cody-kaminsky/drone_video_compression_v2/9-5.1.png

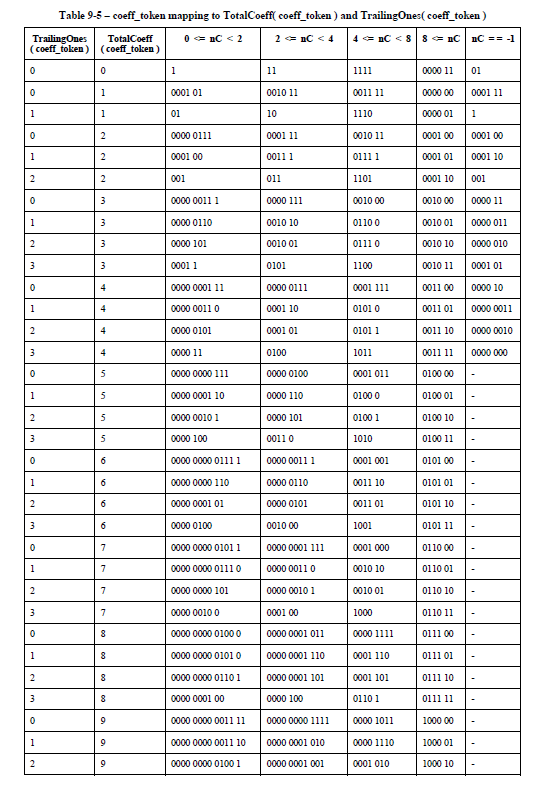
9-5.1.png
