cody-kaminsky/drone_video_compression_v2/9-7.png

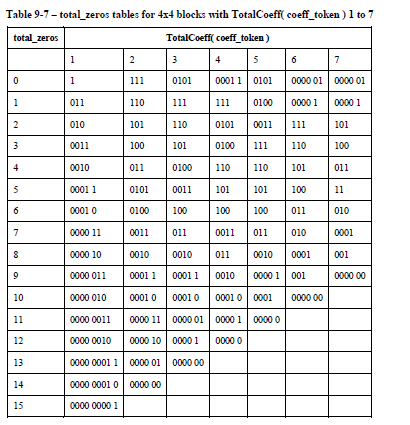
9-7.png
