cody-kaminsky/drone_video_compression_v2/9-8.png

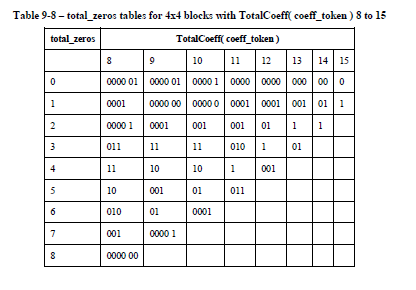
9-8.png
