cody-kaminsky/drone_video_compression_v2/9-9.png

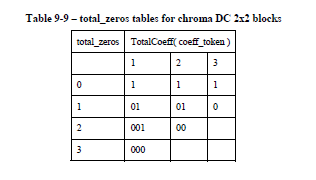
9-9.png
