cody-kaminsky/drone_video_compression_v2/9-10.png

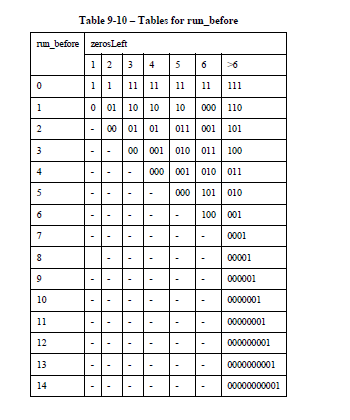
9-10.png
