cody-kaminsky/drone_video_compression_v2/src/vhdl/mb_header_engine.vhd

--------------------------------------------------------------------------------
-- mb_header_engine.vhd
--
-- Macroblock header for I slices: computes coded_block_pattern from the
-- per-block nonzero flags and emits the header syntax elements of spec
-- 7.3.5 as variable-length fields for a bit_packer, exactly as
-- mb_compute_cbp + mb_cavlc_emit in src/encoder.c do:
--
--   I_4x4   : mb_type ue(0); 16 x prev_intra4x4_pred_mode_flag [+ 3-bit
--             rem_intra4x4_pred_mode] in block scan order; intra_chroma_
--             pred_mode ue(v); coded_block_pattern me(v) (Table 9-4 intra
--             column); mb_qp_delta se(0) only if cbp != 0.
--   I_16x16 : mb_type ue(1 + mode + 4*cbp_chroma + 12*cbp_luma);
--             intra_chroma_pred_mode ue(v); mb_qp_delta se(0).
--
-- QP is fixed per frame, so mb_qp_delta is always 0 ('1'). Exp-Golomb
-- codes are emitted as one field: value v+1 with length 2*bits(v+1)-1;
-- the bit_packer treats the missing high bits as the leading zeros.
--
-- predIntra4x4PredMode (spec 8.3.1.1) uses the in-MB modes for inner
-- blocks and the line buffer's top/left modes at the MB edge; if either
-- neighbour is unavailable the prediction is DC.
--
-- luma_nz_i(k) (raster br*4+bc) must be "block k has a nonzero level"
-- over the 16 coefficients for I_4x4, or over the 15 AC coefficients for
-- I_16x16 -- the caller knows which levels it has.
--
-- One field per cycle while fready_i; a header takes at most 20 cycles.
--------------------------------------------------------------------------------

library ieee;
use ieee.std_logic_1164.all;
use ieee.numeric_std.all;

entity mb_header_engine is
    port (
        clk           : in  std_logic;
        rst_n         : in  std_logic;
        start_i       : in  std_logic;
        ready_o       : out std_logic;
        is_i4x4_i     : in  std_logic;
        mode16_i      : in  unsigned(1 downto 0);
        modes4_i      : in  std_logic_vector(63 downto 0);   -- 16 x 4 bits, raster
        mode_chroma_i : in  unsigned(1 downto 0);
        luma_nz_i     : in  std_logic_vector(15 downto 0);   -- raster
        chroma_dc_nz_i: in  std_logic;
        chroma_ac_nz_i: in  std_logic;
        mode4_top_i   : in  std_logic_vector(15 downto 0);   -- 4 x 4 bits (bc)
        mode4_left_i  : in  std_logic_vector(15 downto 0);   -- 4 x 4 bits (br)
        avail_top_i   : in  std_logic;
        avail_left_i  : in  std_logic;
        -- field stream
        fbits_o       : out unsigned(15 downto 0);
        flen_o        : out unsigned(5 downto 0);
        fvalid_o      : out std_logic;
        fready_i      : in  std_logic;
        -- results
        done_o        : out std_logic;
        hdr_bits_o    : out unsigned(7 downto 0);
        cbp_luma_o    : out unsigned(3 downto 0);
        cbp_chroma_o  : out unsigned(1 downto 0);
        has_residual_o: out std_logic
    );
end entity;

architecture rtl of mb_header_engine is

    type u8_tab is array (0 to 47) of integer range 0 to 47;
    constant CBP_CODENUM : u8_tab := (
         3, 29, 30, 17, 31, 18, 37,  8, 32, 38, 19,  9, 20, 10, 11,  2,
        16, 33, 34, 21, 35, 22, 39,  4, 36, 40, 23,  5, 24,  6,  7,  1,
        41, 42, 43, 25, 44, 26, 46, 12, 45, 47, 27, 13, 28, 14, 15,  0);

    type i16_tab is array (0 to 15) of integer range 0 to 3;
    constant SCAN_BR : i16_tab := (0,0,1,1, 0,0,1,1, 2,2,3,3, 2,2,3,3);
    constant SCAN_BC : i16_tab := (0,1,0,1, 2,3,2,3, 0,1,0,1, 2,3,2,3);

    -- Exp-Golomb ue(v) as (value, length): value = v+1, length = 2*bits-1
    procedure ue_field(v : in integer range 0 to 63;
                       bits : out unsigned(15 downto 0); len : out unsigned(5 downto 0)) is
        variable code : unsigned(6 downto 0);
        variable nb   : integer range 1 to 7;
    begin
        code := to_unsigned(v + 1, 7);
        if    code(6) = '1' then nb := 7;
        elsif code(5) = '1' then nb := 6;
        elsif code(4) = '1' then nb := 5;
        elsif code(3) = '1' then nb := 4;
        elsif code(2) = '1' then nb := 3;
        elsif code(1) = '1' then nb := 2;
        else                     nb := 1;
        end if;
        bits := resize(code, 16);
        len  := to_unsigned(2 * nb - 1, 6);
    end procedure;

    function mode_of(v : std_logic_vector; k : integer) return integer is
    begin
        return to_integer(unsigned(v(4*k+3 downto 4*k)));
    end function;

    -- Modes are held in block SCAN order and shifted out one per step; the
    -- neighbours a block needs are then fixed taps into a short history of
    -- the modes already emitted: top is 2 back (odd row of a quadrant) or
    -- 6 back (top row of quadrants 2/3), left is 1 back (odd column) or
    -- 3 back (blocks 4,6,12,14). No 16:1 muxes.
    type mode_arr is array (0 to 15) of unsigned(3 downto 0);
    type hist_arr is array (1 to 6) of unsigned(3 downto 0);

    signal busy      : std_logic := '0';
    signal step      : integer range 0 to 20 := 0;
    signal i4        : std_logic := '0';
    signal m16       : unsigned(1 downto 0) := (others => '0');
    signal sr        : mode_arr := (others => (others => '0'));
    signal hist      : hist_arr := (others => (others => '0'));
    signal mchroma   : unsigned(1 downto 0) := (others => '0');
    signal cbp_l     : unsigned(3 downto 0) := (others => '0');
    signal cbp_c     : unsigned(1 downto 0) := (others => '0');
    signal m4top, m4left : std_logic_vector(15 downto 0) := (others => '0');
    signal atop, aleft : std_logic := '0';
    signal fbits_q   : unsigned(15 downto 0) := (others => '0');
    signal flen_q    : unsigned(5 downto 0) := (others => '0');
    signal fvalid_q  : std_logic := '0';
    signal done_q    : std_logic := '0';
    signal nbits     : unsigned(7 downto 0) := (others => '0');
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
