cody-kaminsky/drone_video_compression_v2/(commit log)

2026-05-02 Initial commit: H.264 baseline-profile intra-only encoder
    A from-scratch C reference encoder for FPGA-targeted drone video
    compression. Validated byte-exact against ffmpeg across:
    - 5 4K drone images (3840x~2500): 25/25 pass at QPs 18,22,26,30,38
    - Kodak set (24 images, 768x512): 144/144 pass at QPs 18,22,26,30,38,46
    - Synthetic complex content: all sizes 16x16 to 768x128 at QPs 10-51
    Implements: NAL/RBSP framing, SPS/PPS, IDR slice header, I_16x16 + chroma
    8x8 prediction, 4x4 integer DCT + Hadamard for DC, full CAVLC entropy
    coding (coeff_token, levels, total_zeros, run_before).
    CAVLC tables verified against x264 reference (tools/diff_x264.py).
2026-05-02 Phase A: strip non-synthesizable scaffolding from encoder
    The C reference is the source of truth for the upcoming HLS port. Three
    classes of construct don't survive the trip and need to go before the
    structural refactor in Phase B:
    1. getenv / fprintf debug paths in hot loops (encoder.c, cavlc.c,
    bitstream.c) — neither synthesizes, and they obscure the dataflow that
    HLS needs to see.
    2. malloc / calloc / free for per-frame buffers (recon planes, nC arrays,
    RBSP slice payload). Replaced by a static arena sized for the
    architecture max (MAX_W x MAX_H = 4K). Total ~24 MB of .bss, of which
    the active sub-region is memset on each call.
    3. Self-recursion in predict_chroma_8x8 (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
    [bitstream.c, cavlc.c, encoder.c, intra.c]
2026-05-02 Phase B: split encode_mb_emit into typed pipeline stages
    The old encode_mb_emit was a 275-line monolith that interleaved mode
    decision, forward+inverse transforms, CBP derivation, and CAVLC emission.
    That structure doesn't map onto the architecture diagram in §8 of
    architecture.txt, and it's the wrong shape for the HLS port: HLS needs
    each pipeline stage as its own pure function with a typed payload between
    stages so it can pragma-pipeline across stage FIFOs.
    This commit factors the per-MB encode into 8 stage functions matching
    architecture.txt §9 one-for-one:
    stage 0 mb_fetch gather src + neighbor samples
    stage 1 mb_mode_decide I_16x16 SATD + chroma SAD picks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
    [encoder.c, mb_state.h]
2026-05-02 Phase C: separate PSNR / bpp from the encoder kernel
    The FPGA encoder IP, per architecture.txt §10, returns BS_BYTES_OUT and
    perf counters — it does not compute PSNR. PSNR is a host-side measurement
    function, and putting it inside the kernel ties the C reference to a
    shape the hardware will not have.
    Moved psnr_plane and psnr_chroma_component into a new psnr.h/psnr.c
    module. encode_frame_h264 (the bitstream-emitting kernel that maps to the
    FPGA IP) is now integer-only — no doubles, no math.h, no log10. It fills
    total_bits, bytes_out, mb_count and leaves the PSNR / bpp slots in
    encode_stats_t at zero.
    main.c is the test bench: after the kernel returns it computes PSNR from
    src vs the r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
2026-05-02 Graft I_4x4 onto the staged emit path; drop the bit-estimate prototype
    The architecture (architecture.txt §2) keeps both I_16x16 and I_4x4 luma
    intra prediction in scope, and §9 budgets the mode-decision SATD engines
    to evaluate all 9 I_4x4 modes alongside the 4 I_16x16 modes. Until now
    I_4x4 only existed in encode_mb's bit-estimation prototype; the bitstream
    emitter (encode_frame_h264 + encode_mb_emit) was I_16x16-only. This commit
    folds I_4x4 into the staged pipeline and removes the prototype.
    Approach
    --------
    mb_mode_decide now runs both candidate paths in full (forward + inverse
    + recon for each) and picks the winner by estimated CAVLC bits. I_4x4's
    per-block dependency chain forces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
2026-05-02 Disable I_4x4 path selection until cross-MB-boundary bug is found
    Running tools/validate_byteexact.sh against the Kodak (24 imgs) and drone
    aerial (5 imgs) datasets revealed that the I_4x4 graft has a real bug:
    all 120 Kodak tests fail when the path selector is active, with no ffmpeg
    parser errors but with consistent recon divergence at the first I_4x4 ↔
    I_16x16 macroblock boundary in raster order.
    Diagnostic data:
    - I_16x16-only (forced bits_b = MAX): 145/145 byte-exact across both
    datasets and QPs 18/22/26/30/38.
    - I_4x4-only (forced bits_a = MAX): byte-exact on every individual test
    case I tried (kodim01 at QP 18/26/38 confirmed).
    - Mixed (selector active): 120/120 Kodak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
    [encoder.c, types.h]
2026-05-03 Add CAVLC self-check + I_4x4 bug debug session findings
    Two changes:
    1. CAVLC self-check (cavlc.c). Guarded by `#ifdef CAVLC_SELFCHECK`,
    wraps cavlc_encode_block to encode-then-decode each block to a
    scratch buffer and compare. Built with -DCAVLC_SELFCHECK and ran
    against the failing case (kodim01 QP30 with I_4x4 selector active):
    zero mismatches reported. The CAVLC layer is consistent given the
    encoder's nC.
    2. Updated docs/i4x4-boundary-bug.md with this session's findings:
    - Per-MB forcing bisect localized the bug as content/mode-specific,
    NOT just any I_4x4-with-I_16x16-neighbor case. Forcing only
    MB (0, 2) to I_4x4 triggers the bug; forcing only MB (0, 1) or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
    [cavlc.c, encoder.c]
2026-05-05 Add per-MB self-decoder; rules out broad classes of bugs
    Built a full per-MB CAVLC self-decoder in encoder.c (under
    #ifdef MB_SELFDECODE). After each mb_cavlc_emit call, it:
    1. Re-parses the MB's emitted bits using our cavlc_decode_block.
    2. Walks every syntax element: mb_type, 16 prev/rem mode flags
    (with full predIntra4x4PredMode lookup), intra_chroma_pred_mode,
    me(CBP), mb_qp_delta, residual blocks (luma DC for I_16x16,
    full luma for I_4x4, chroma DC, chroma AC).
    3. Compares every parsed value to encoder intent (mb_state_t).
    4. Maintains parallel dec_state that mirrors a spec decoder's
    tracked neighbor counts; compares to encoder's ncs after each MB.
    Result on kodim01 QP30 w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
    [encoder.c]
2026-05-05 Fix I_4x4 boundary bug; M2 cleanups for HLS port
    The I_4x4 ↔ I_16x16 boundary bug was a spec misinterpretation in
    emit_intra4x4_mode (and the mirrored copy in verify_mb_at): when either
    4x4 neighbor was inside an I_16x16 macroblock, the code forced
    predIntra4x4PredMode = DC instead of substituting effective mode 2 (DC)
    for that neighbor and then taking Min(top, left). The distinction
    matters whenever the OTHER neighbor's mode is < 2 (V or H): spec wants
    Min(mode, 2) = mode, but the buggy code wrote 2. Encoder and self-
    decoder shared the wrong rule, so MB_SELFDECODE never caught it; pure-
    I_4x4 and pure-I_16x16 runs hit the wrong branch zero times, so they
    were byte-exact. Mixed-mode was t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
    [encoder.c]
2026-05-05 M3 phase 1: HLS port with line-buffered recon (src/hls/)
    The C reference in src/ is untouched; the HLS-targeted port lives in
    src/hls/ as a separate set of source files that share the transform /
    quant / intra / cavlc / bitstream / nal / psnr modules with the C
    reference. Both binaries (build/dcc_encoder and build/dcc_hls) are
    built from the same Makefile.
    Key change vs C reference: the W*H static recon plane (3.1 MB at 1080p,
    15 MB at MAX_W*MAX_H) is replaced by a line buffer holding only the
    edges intra prediction actually reads — bottom row of the MB row above
    plus the right column of the MB just to the left. Footprint at 1080p
    drops to ~15 KB, well within Zynq-7030 BRAM.
    src/hls/li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
    [encoder.c, encoder_hls.h, hls_pragmas.h, hls_top.c, line_buffer.c, line_buffer.h, main.c]
2026-05-05 M3.2: HLS pragmas + Vitis HLS driver scripts
    Annotates the HLS port for synthesis, ready to run vitis_hls -p
    src/hls/csynth.tcl. Pragmas are gated by HLS_PRAGMA() (defined in
    hls_pragmas.h) — inert under gcc, so the dcc_encoder and dcc_hls
    binaries continue to build byte-exact against ffmpeg / each other.
    src/hls/encoder.c
    - ARRAY_PARTITION on mb_state_t large fields inside encode_mb_emit
    (ac_levels_y_full, ac_levels_*, dc_levels_*, neighbor edges,
    modes4) so inner loops can reach II=1.
    - PIPELINE pragmas on the chroma forward / inverse / quant / recon
    4-block loops in mb_residual / mb_transform / mb_quantize /
    mb_reconstruct.
    - LOOP_TRIPCOUNT hints o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
2026-05-05 HLS: replace line-buffer pointer-swap with index flip
    Vitis HLS rejects pointer phi nodes — pointers whose underlying object
    depends on a runtime-decided control path are not synthesizable
    ("Pointer (phi) points to an unknown underlying object", HLS 214-390).
    The line_buffer ping-pong used pointer swaps in lb_begin_mb_row to
    promote the just-filled bank into the read position. After the swap,
    every gather_* call's read of lb->top_y was a phi between two
    underlying static arenas — exactly the pattern HLS can't bind.
    Fix: store both banks inside line_buffer_t as a [2][MAX_W] array and
    keep an integer top_idx selecting which bank is the read side. Reads
    become buf_y[lb->top_idx][...]; wri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
    [encoder.c, line_buffer.c, line_buffer.h]
2026-05-05 HLS iteration 2: line-buffer all the cross-MB state, relax pragmas
    Closes the BRAM blowout (1018% utilization in iteration 1) by extending
    the line-buffer pattern beyond the recon plane to ALL frame-scale
    arenas. Same access pattern, same fix.
    Structural change — nC and mode4 join recon in line_buffer_t:
    Before: arena_luma_nc / arena_chroma_u_nc / arena_chroma_v_nc /
    arena_luma_mode4 — frame-scale grids of 4x4-block context.
    Sized W/4 * H/4 (luma) and W/8 * H/8 (chroma). At MAX_W=3840
    that's ~720 KB total.
    After: All four collapsed into line_buffer_t — top row + left col
    per channel. ~5 KB total. Same ping-pong + index-flip shape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
    [encoder.c, line_buffer.c, line_buffer.h]
2026-05-06 HLS iteration 3: skip per-frame NAL writes + CAVLC heuristic for synth
    Two surgical __SYNTHESIS__-only changes targeting the LUT explosion that
    iteration 2 didn't touch. Both keep the gcc-built dcc_hls.exe byte-
    identical to the C reference.
    (1) Skip nal_write_sps / nal_write_pps / nal_emit_idr under __SYNTHESIS__.
    These run ONCE per frame, write ~30 bytes total, but synthesize to
    ~40k LUT (50% of the xc7z030 budget) because their bs_put_ue /
    bs_put_se / RBSP-escape inner loops are variable-length-output
    machinery that HLS expands fully. For a fixed (W, H, qp) target the
    SPS+PPS bytes are CONSTANT — the right place to compute them is once
    on the host (PS) at boot,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
    [encoder.c]
2026-05-06 HLS iteration 4: drop I_4x4 candidate + force kernel sharing
    User-flagged the obvious: comparable H.264 baseline encoders are in the
    20-30k LUT range. Iteration 3 still landed at 177k (225%), 6-9x off.
    Two attacks:
    (1) Drop try_path_i4x4 from synthesis.
    The C reference evaluates BOTH I_16x16 and I_4x4 candidates and
    picks the cheaper. try_path_i4x4 alone consumed ~22% of the LUT
    budget — it runs a full per-block forward+inverse loop, evaluates
    9 prediction modes per block, and computes a CAVLC bit estimate,
    even when I_16x16 wins (which is the common case).
    Under __SYNTHESIS__, force bits_b = INT32_MAX so the selector
    always picks I_16x16. Per architecture.txt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
2026-05-06 M4 phase 1.5: stub cavlc_encode_block under __SYNTHESIS__ (preview only)
    Replaces all 9 cavlc_encode_block call sites in src/hls/encoder.c with
    a CAVLC_ENCODE_BLOCK macro. Under __SYNTHESIS__ the macro expands to a
    no-op (just (void) casts to silence unused-variable warnings); under
    gcc it expands to the real cavlc_encode_block call.
    This is a SYNTHESIS-REPORT PREVIEW only. The synthesized hardware does
    not emit residual data, so cosim and ffmpeg-decode parity will fail.
    The point is to see the LUT count Vitis HLS produces with CAVLC's 12k
    LUT block factored out — i.e., what M4 phase 2 step 6 (HLS refactor to
    hls::stream<level_packet_t>) will eventually deliver, before doing the
    full VHDL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
    [encoder.c]
2026-05-06 docs: M4 architecture-pivot plan (no code change)
    Captures the decision to move from "HLS does everything" to "HLS as
    director + hand-VHDL for dataflow blocks". Self-contained handoff
    document for resuming M4 work in a new session.
    Contents:
    1. Current state — commit history, build status, last synthesis
    numbers (LUT 153% with CAVLC stubbed; 201% with CAVLC inline;
    projected ~80% with full M4 + dropping functionality).
    2. Pivot rationale — comparable hand-VHDL designs ship at 20-30k
    LUT WITH all functionality; HLS keeps generating 6-9× the
    hardware. The fix isn't more pragmas, it's switching paradigms.
    3. New architecture — top-level diagram, per-block estim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
2026-05-15 fix bit_packer: out_last race on flush + TEXTIO integer overflow
    The out_last signal was never asserted when flush_i arrived in the same
    cycle as the final full-byte emission (state still S_NORMAL). Also, the
    testbench used integer READ for 32-bit unsigned values, overflowing on
    values > 2^31-1. Switch vector format to hex and use hread.
    [bit_packer.vhd, bit_packer_tb.vhd]
2026-05-15 fix cavlc_engine: run_before loop exiting one iteration early
    The loop condition idx <= 1 skipped the final run_before between
    nz_pos[1] and nz_pos[0]. Changed to idx < 1 to match the C reference
    loop (idx >= 1 && zeros_left > 0).
    [cavlc_engine.vhd]
2026-05-15 tcl: switch sim scripts to explicit xvhdl/xelab/xsim flow
    Replace create_project/launch_simulation with direct xvhdl, xelab, xsim
    calls so the scripts work in a plain Vivado Tcl console without needing
    project infrastructure.
2026-05-15 fix transform_engine: truncate i16 outputs + exec xsim in tcl scripts
    dct4x4 and hadamard2x2 output i16 in C; the VHDL was returning full
    32-bit results, causing mismatches on overflow inputs. Add trunc16 to
    match the C (i16) cast. Also fix xsim calls to use exec prefix.
    [transform_engine.vhd]
2026-05-15 transform_engine: shared butterfly, single-cycle, area-optimized
    Replace 8×3 duplicated butterfly instances with 8 instances of one
    shared mode-muxed butterfly. Same 1-cycle latency and throughput.
    Synthesizer can now share pre-add logic across DCT/IDCT/Hadamard modes.
    [transform_engine.vhd]
2026-05-15 fix cavlc_engine_tb: collect bytes by count, not out_last
    When bit_count is an exact multiple of 8, all full bytes are emitted
    during encoding before the flush. The bit_packer's flush finds an
    empty accumulator and never asserts out_last, causing the testbench
    to hang. Fix by collecting exactly exp_count bytes, then waiting for
    the engine to return to idle (in_ready).
    [bit_packer.vhd]
2026-09-09 cavlc_engine: fix dropped pushes, pipeline count, cut area 2919 -> 774 LUTs
    Functional fixes:
    - bit_packer: remove stray `end if;` that broke compilation (sims were
    silently using a stale library copy).
    - cavlc_engine: hold bp_valid until the packer accepts. Ready was sampled
    a cycle early and not held, so a 28-bit escape level pushing the
    accumulator past 32 bits dropped the following field (first seen at
    vector 21). Latch the coeff_token pulse; flush only with nothing pending.
    Timing / area:
    - Split the S_COUNT scan into mask + count stages (was a 16-deep chain
    of 16-bit compares into trailing_ones; WNS -2.18 ns -> +0.38 ns at
    200 MHz on xc7z030-3).
    - Walk the nonzero mask wit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
    [bit_packer.vhd, cavlc_engine.vhd, cavlc_vlc_rom.vhd, coeff_token_encoder.vhd]
2026-09-10 vhdl: dataflow blocks (transform, quant, predict, cost, recon, line buffer, MB header, CAVLC dispatch)
    Area-optimized transform_engine (shared butterfly, W=20, DIR generic).
    New engines with C-golden testbenches and xsim drivers:
    quant_engine, predict_4x4/16x16/chroma_engine, cavlc_cost_engine
    (systolic, lat 19) and cavlc_cost_engine_ll (position-parallel, lat 5),
    recon_engine (optional SSD), line_buffer (HLS line_buffer_t in HW),
    mb_header_engine (CBP + Exp-Golomb header fields), cavlc_dispatch
    (per-engine packet FIFOs, order FIFO, in-order byte merger).
    bit_packer: per-flush-group bit count. cavlc_engine: block_bits_o and
    flushed_o ports, single-shot drain flush, registered level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
2026-09-10 encoder kernel: N=3 mode decider, MB pipeline controller, frame I/O, top
    C reference: I_4x4 decision is now SATD screen + mode-bit penalty,
    3-candidate shortlist scored by J = 16*SSD + lambda*bits (integer
    tables in src/rd_tables.h); HLS copy updated; per-MB and per-frame
    vector dumps (DCC_DUMP_MB / DCC_DUMP_SRC / DCC_DUMP_SLICE / DCC_DUMP_ITEMS).
    VHDL: mode_decide_engine (shared datapath, tagged free-running
    pipelines, wavefront pairs, chroma screen in idle windows),
    mb_pipeline_controller (line buffer + decider + header + CAVLC dispatch,
    nC/zigzag/packets, double-buffered source), frame_io (MB-row buffer
    re-tiled to 4x4 words, 32-bit AXI-Stream in/out), encoder_top.
    predict_16x16_engine: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
    [encoder.c, encoder_top.vhd, encoder_top_tb.vhd, frame_io.vhd, frame_io_tb.vhd, mb_pipeline_controller.vhd, mb_pipeline_controller_tb.vhd]
2026-09-10 mode decider: register stages for timing (recon input, rank insert, rate term, 4x4 predictor inputs); frame_io lane RAMs + registered write address; hex pixel stream
2026-09-10 mode decider: open-loop screen hybrid, fused dequant, J fold; controller overlap; 3-frame 1080p test
    Decision policy (C reference, HLS copy, rd_tables.h): the I_4x4 screen ranks
    every mode against open-loop neighbours (reconstructed where the neighbour is
    another MB, source where it is in-MB); the top-3 shortlist is still evaluated
    closed-loop. C sweep: -3.45% BD-rate vs the SATD-only reference, 0.6% behind
    the closed-loop screen. Reference == HLS byte-exact, ffmpeg decode exact.
    mode_decide_engine: screen sequencer (16 blocks in wavefront order, 4-cycle
    source-RAM prep, dedicated 14-bit Hadamard lane + abs tree, per-block top-4
    lists + raw SATD RAM), chain sequencer (prep, 2-cycle rank wit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
    [cavlc_engine.vhd, encoder.c, encoder_top_mf_tb.vhd, mb_pipeline_controller.vhd, mode_decide_engine.vhd, quant_engine.vhd, rd_tables.h, transform_engine.vhd]
2026-09-11 AXI wrapper, OOC implementation flow, post-route timing fixes
    encoder_axi_top: AXI4-Lite registers (CTRL START/SOFT_RESET/IRQ_EN, CONFIG,
    STATUS, DONE_CLR, FRAMES, CYCLES, BYTES, ID, VERSION), AXI4-Stream pixels in
    and slice payload out (tkeep/tlast), level interrupt, synchronised reset.
    s_axis_tready is held low until START (frame_io accepts and then discards
    words that arrive before frame_start, which corrupted MB 0 when the DMA was
    started early). encoder_axi_top_tb: two frames through AXI, bit-exact,
    register readback checked.
    Timing (from the first post-route report): the transform's DC vector is
    registered when the background issues the HAD beat (W_FWDC 9 -> 10); the
    controller builds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
    [encoder_axi_top.vhd, encoder_axi_top_tb.vhd, mb_pipeline_controller.vhd, mode_decide_engine.vhd]
2026-09-13 M5: package the kernel as IP and build the hardware validation framework
    Target for bring-up is a Zybo Z7-20 (xc7z020clg400-1) at 110 MHz,
    bare-metal. Everything here is verified except the two files that need the
    Vitis BSP.
    Measured on the real part, full out-of-context place and route at 9.091 ns:
    WNS +0.048 ns, WHS +0.028 ns, 23304 LUT (44%), 14651 FF (14%), 29.5 BRAM
    (21%), 49 DSP (22%). An older characterisation had the -1 part at about
    105 MHz with 9.0 ns failing by 0.168 ns; the register-stage work since then
    moved it. The margin is thin, so 110 MHz is a measured ceiling, not a
    comfortable operating point.
    At 337 cycles per macroblock, 1080p is 25.0 ms a frame, so 40 fps. Dropping
    f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
    [board_main.c, codec_kernel.c, codec_kernel.h, h264_host.c, h264_host.h, platform_standalone.c, test_assemble.c]
2026-09-13 M5: Zybo block design, Vitis setup, and a bring-up runbook
    The block design now builds for real. Digilent's board files are installed
    (github.com/Digilent/vivado-boards), and build_zybo_bd.tcl validates end to
    end: PS7 + AXI DMA + the packaged encoder IP, with the encoder at 0x43C00000
    and the DMA at 0x40400000.
    Three things the first run of the script got wrong, all of the kind that
    fails late rather than loudly:
    - The board part was pinned at version 1.0 and the installed one is 1.2.
    A pinned version fails with "not found", which reads like a missing
    install rather than a version bump, so it is resolved by glob now.
    - IPs were named by bare VLNV with no version, which does n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
    [board_main.c]
2026-09-13 M5: Zybo bitstream built at 100 MHz, WNS +0.094 ns
    build/zybo/dcc_enc.xsa and the bitstream exist. 25945 LUT (49%), 18183 FF
    (17%), 34.5 BRAM (25%), 49 DSP (22%), WHS +0.024 ns, no failing endpoints.
    The plumbing costs only about 1900 LUTs and 5 BRAM tiles over the kernel.
    The slack is the interesting part, because it says my earlier estimate was
    wrong in a way worth writing down. Out-of-context slack does not extrapolate
    to in-system slack. The worst path is the same one the OOC run found, the
    mode decider's transform input select into the transform row register, but it
    went from about 9.04 ns standalone to 9.767 ns in the system, and 66% of that
    is routing rather than logic. The encoder p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
2026-09-13 M5: the bare-metal application builds
    The Vitis workspace, platform and application are created and dcc_l4.elf
    links: 281 kB text, 1.27 MB bss, 554 kB on disk. board_main.c and
    platform_standalone.c were the two files that had never seen a compiler, and
    both needed a fix, each Cortex-A9 specific:
    - xtime_l.h does not exist in a Cortex-A9 system-device-tree BSP. It is an
    UltraScale+ (A53/R5) header. The same XTime_GetTime and COUNTS_PER_SECOND
    come from xiltimer.h, which includes xtimer_config.h. Also parenthesise
    COUNTS_PER_SECOND before dividing again: it expands to a bare
    XPAR_CPU_CORE_CLOCK_FREQ_HZ/2 and reassociates otherwise.
    - XAxiDma_Busy returns u32, so %d is a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
    [board_main.c, platform_standalone.c]
2026-09-13 M5: L4 passes on hardware
    A Zybo Z7-20 at 100 MHz encoded the 480x272 test frame and produced a payload
    byte-exact with the C reference: 18717 bytes, matching the simulation and the
    reference, and an 18744-byte Annex B access unit. The chain from the spec
    through the C encoder, the RTL, the packaged IP, the block design and the DMA
    is intact end to end on real silicon.
    174350 cycles, 342 cycles/MB, 1.74 ms. That is 563 cycles (0.32%) faster than
    simulation's 174913, which is worth understanding rather than shrugging at.
    Two effects cancel: board_main.c pulses START before programming the MM2S
    transfer, so the kernel idles while the CPU writes DMA registers, but the real
    DMA streams from DDR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
2026-09-13 M5: manifest-driven sequence run, no staging copy
    Replaces the single linked-in frame with a sequence loaded into DDR over
    JTAG and described by a manifest, so the board application is
    resolution-independent and changing the test sequence never needs a
    recompile.
    The frames are written to DDR already in the kernel's stream order, shuffled
    once on the workstation by tools/gen_stream_frame.c, which calls the same
    h264_nv12_to_stream() that make host_test covers. So the board does no
    staging copy at all: MM2S reads each frame where it lies. At 1080p that
    removes about 3 MB of memcpy per frame, which was the main thing eating the
    33 ms budget at 30 fps and the main argument for reaching for
    sca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
    [board_main.c, dcc_memmap.h]
2026-09-13 M5: the board waits for the manifest instead of needing a breakpoint
    The application read the manifest once at startup, so launching it from Vitis
    meant it ran straight past and reported a missing manifest before the data
    could be pushed in. Avoiding that needed a breakpoint at main, which is fiddly
    and easy to get wrong.
    It now polls for the manifest and prints what to run. The order becomes:
    launch from Vitis, let it run, then run the generated load.tcl, which halts the
    core, writes the data and resumes into the poll.
    The poll invalidates the cache on every pass. JTAG writes DDR behind the data
    cache, so once the loop has read that address the CPU would hold the stale line
    forever and ne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
    [board_main.c]
2026-09-13 M5: bound every wait, dump state on a stall, consume the manifest
    The 1080p run passed frame 0 (256713 bytes byte-exact, 338 cycles/MB against
    simulation's 337) and then stopped dead on frame 1 with no message. That is
    this file's fault, not the kernel's: the wait for S2MM to go idle had no
    timeout at all, and every other bound went through dcc_time_us(), which
    silently becomes infinite if the A9 global timer is not running. An infinite
    wait is indistinguishable from a hardware hang.
    Every wait is now bounded by an iteration count that does not trust the
    timer, and a stall prints what it was waiting for plus the kernel STATUS
    decoded bit by bit, FRAMES/CYCLES/BYTES, and both DMA channels' c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
    [board_main.c]
2026-09-13 M5: add scripts/clear_manifest.tcl
    DDR does not reliably clear on a power cycle, so a manifest can outlive the
    frames it describes. The application now clears its own magic after latching
    one, but an interrupted load or a crashed run can still leave a plausible
    manifest behind. This zeroes the header and reads it back to confirm.
    Wiping DDR wholesale is not the answer: the frame region alone is 448 MB, and
    filling it over JTAG would take hours. The magic is the only word that gates
    anything.
2026-09-13 M5: find the tlast bug hardware hit, work around it, document three faults
    Running a sequence rather than a single frame broke, and the stall dump
    localised it exactly. Three separate faults, each interesting for what missed
    it.
    B1, fatal: m_axis_tlast is lost on one frame in eight. bit_packer emits a byte
    as soon as it has eight bits, and its own header documents the consequence --
    a flush that finds an empty accumulator emits no byte and never sets out_last.
    So when the payload's bit count including the RBSP stop bit is an exact
    multiple of 8, the last byte has already left and nothing carries tlast. That
    signal goes straight through cavlc_dispatch and frame_io to m_axis_tlast, and
    a leng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
    [board_main.c, encoder_axi_top_tb.vhd]
2026-09-13 M5: reproduce the tlast bug in simulation
    Encoding the same 480x272 test frame at QP 23 instead of 26 gives a
    24451-byte payload with (macroblock_layer_bits + 1) mod 8 == 0, the
    triggering condition. The testbench then reports zero byte mismatches and
    hangs on the watchdog at 8 ms, waiting for a last_seen that never arrives.
    That is the hardware symptom exactly: all data correct, no tlast. Hardware
    found the bug and it is now pinned to a deterministic five-minute simulation,
    which is the regression test the fix has to pass. It must report PASS at QP 23
    as well as at QP 26.
    Testbench defaults restored to QP 26 and the original backpressure pattern.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
    [encoder_axi_top_tb.vhd]
2026-09-13 fix: hold a byte back in the output bit_packer so the frame flush can mark it
    bit_packer gains a HOLD_LAST generic, default false, enabled only on the
    packer in cavlc_dispatch whose out_last becomes m_axis_tlast. With it set the
    packer emits at 16 accumulated bits rather than 8, so a byte is always still
    inside when the frame flush arrives and there is something left to mark.
    The default stays false because the engine-side packers are flushed after
    every block and the dispatcher's merger already compensates for this exact
    behaviour by holding a byte back itself; enabling it there would hold two.
    The failure was worse than "tlast is missing". frame_io's byte-to-word packer
    only marks a word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
    [bit_packer.vhd, cavlc_dispatch.vhd]
2026-09-13 fix: latch the block trim length in the merger
    The dispatcher's merger computed the trim for a block's last byte
    combinationally:
    r := to_integer(eng_blk_bits(cur_e)(2 downto 0));
    but block_bits_o is only valid from flush_i until flushed_o, and the packer
    restarts the count immediately after. On the cycle the engine's flushed pulse
    arrives r is correct. If op_ready happens to be low that cycle there is no
    handshake, and on the next cycle the count has already restarted, so r reads 0
    -- which this code treats as a full 8 bits. The merger then pushes 8 bits
    where it should have pushed block_bits mod 8.
    That is the four inserted zero bits the stream analysis found, recurring at
    block bou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
    [cavlc_dispatch.vhd, encoder_axi_top_tb.vhd]
2026-09-13 docs: record the merger trim fix and the post-fix verification matrix
    Both output-path bugs are now fixed and validated across the four
    combinations of payload alignment and backpressure. Before the fixes, three
    of the four failed: two watchdog hangs and one mid-frame corruption. BP_MODE
    defaults to the adversarial pattern so the regression stays covered.
    [encoder_axi_top_tb.vhd]
2026-09-13 fix: bytes_last captured the count before the final beat
    bytes_run and bytes_last are both signals, so an assignment to bytes_run is
    not visible to a read of it in the same process. When the frame's final beat
    handshakes on the same cycle k_done arrives -- which is exactly when it is
    most likely to -- bytes_last captured the pre-increment value and the register
    reported one beat short. Hardware read 253656 for a 253657-byte payload;
    253657 mod 4 = 1, so the missing beat carried one byte.
    The total is now computed once into a variable and used for both.
    The first attempt at this made the bytes_run assignment unconditional, which
    put it later in the process than the START handler's clear. Th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
    [encoder_axi_top.vhd]
2026-09-13 scripts: program_fpga.tcl prefers the platform's bitstream copy
    The Vivado run directory is recreated by every rebuild, so a bitstream inside
    it vanishes the moment another build starts -- which is exactly what happened
    while the default pointed there. The Vitis platform's exported copy is stable
    and is what the board would actually have been programmed with, so try that
    first and fall back to the build directory.
2026-09-13 scripts: run_board.tcl drives the whole board flow from one command
    Programs the PL, brings up the PS via ps7_init from the hardware handoff,
    downloads the ELF, loads the test sequence and runs. No IDE involved.
    Driving the board from Vitis means a run configuration whose Program FPGA
    setting decides whether the PL is reconfigured, and PL configuration survives
    an ELF download and a PS reset. Getting that wrong runs new software against
    an old bitstream and reports nothing unusual, which has now cost two hardware
    runs. This script always programs, so the question cannot arise.
    The sequence generator gains addrs.tcl, a data-only loader with just the
    dow -data lines, so the run script can so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
2026-09-13 scripts: absolute default sequence path in run_board.tcl
    xsdb does not start in the project root, so the relative default resolved
    against whatever directory the shell was in and the script failed before it
    reached the board.
2026-09-13 fix: correct the PS bring-up order in run_board.tcl
    The run failed at the ELF download with 'Cannot access DDR: the controller is
    held in reset'. Three things were wrong and a catch was hiding the first two.
    - rst -processor resets only the CPU. A Zynq needs rst -system, and that
    clears PL configuration too, so it has to come BEFORE the bitstream
    rather than after it.
    - ps7_init is what releases the DDR controller. Until it runs every write
    to DDR fails, which is exactly what a download to 0x100000 hits.
    - ps7_init and ps7_post_config were wrapped in catch, so their failure was
    swallowed and the script printed 'PS initialised' before dying two steps
    later at a symp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
2026-09-13 fix: source ps7_init.tcl directly, and start the A9 global timer
    loadhw does not define ps7_init in the system-device-tree platform flow, so
    the call failed with 'invalid command name'. The generated Tcl is right there
    in the platform export and defines ps7_init, ps7_post_config and ps7_debug, so
    source it.
    While reading that file: it ends by writing 0 to 0xF8F00208, the A9 global
    timer control register, leaving the timer stopped. That is why the application
    has reported 'timer NOT RUNNING' on every run and why every millisecond figure
    it printed was meaningless. The same file provides perf_reset_and_start_timer,
    so the script now starts it and the timing numbers become real.
    Co-Authored-B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
2026-09-13 M5: L5 passes on hardware at 1080p
    100 frames at 1920x1088 QP 26, every payload byte-exact with the C reference.
    816,000 macroblocks across four distinct frames cycled 25 times, including the
    253657-byte frame whose missing final byte hung every previous attempt.
    cycles/MB 337.7 hardware, 337.0 simulation
    frame 27.56 ms, 36.3 fps at 100 MHz
    1080p30 met with 21% margin
    spread 1701 cycles over 100 frames, 0.06%
    bitrate 60.9 Mbps at QP 26
    The banner read 'version 1.1', which is the VERSION bump doing its job: proof
    the fixed bitstream was configured rather than an inference from timestamps.
    The timer read 'running' for the first time, so the millisecond figures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
2026-09-13 fix: DONE means the frame is emitted, not that the kernel stopped
    Found on the first run of the new input-side stress. The kernel can finish
    while its last output beat is still in flight, so k_done and "frame emitted"
    are separate events. With the old feeder, which never withheld data for long,
    they always coincided. Under sustained input stalls they separate and k_done
    arrives first, so bytes_last was captured before the final beat: BYTES read
    18716 for an 18717-byte payload.
    The counter was the visible symptom. The contract was the real problem. A host
    that starts the next frame when it sees DONE would do so with a beat still
    pending in m_axis. The board application is safe only because i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
    [board_main.c, dcc_memmap.h, encoder_axi_top.vhd, encoder_axi_top_tb.vhd]
2026-09-13 host: show the per-record QP in the sweep output
    Two printf changes from the manifest v2 commit had not actually applied, so a
    QP sweep printed 'frame N' with no indication of which QP produced it, which
    makes the results unreadable. The functional half, using the record's QP
    rather than the manifest's, was already in.
2026-09-13 docs: throughput versus QP, measured on hardware
    A ten-point QP sweep, 50 frames, every payload byte-exact, including QP 23
    whose payload is a whole number of bytes -- the alignment that used to lose the
    frame's final byte. Passing it on hardware confirms the bit_packer fix
    directly rather than by simulation.
    Throughput is flat at 341.3 cycles/MB for QP 30 and above: that is the mode
    decision, which does the same work regardless of QP. Below QP 22 entropy
    coding starts to dominate and QP 14 costs 395.8 cycles/MB, 16% more.
    The consequence is worth recording. 1080p30 is met across the whole QP range,
    but the margin is not the 20% a QP 26 measurement suggests: at QP 14 it is
    3.2%. Rate contr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
2026-09-13 host: measure the system frame rate, not just the PL's
    The CYCLES register counts START to DONE inside the PL and says nothing about
    what the host spends between frames re-arming DMA, maintaining caches and
    checking results. Reporting 36.3 fps from it alone overstates what a camera
    feed would actually get, because the loop a real capture has to keep up with
    is the whole thing, not the fast part of it.
    The run now times the encode phase and the verify phase separately with the
    A9 global timer, which started working once run_board.tcl began calling
    perf_reset_and_start_timer. A real pipeline does the encode phase and not the
    verify phase, so the system rate is reported from the former, with t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
2026-09-13 docs: system frame rate measured, and the real 30 fps margin
    Host overhead is 0.83 ms a frame, 3% -- far less than the 3-5 ms estimated
    before measuring. The difference is the cache fix: payload invalidates had
    been covering the whole 8 MB buffer rather than the roughly 250 kB actually
    written.
    System rate at 1080p QP 26 is 28.39 ms, 35.2 fps, against the PL's own 27.56
    ms and 36.3 fps. The loop is steady to 0.04 ms across 100 frames.
    Combining that with the QP sweep gives the margin that actually matters. At
    QP 26 the system has 16%; at QP 14 it has 0.6%, 33.13 ms against a 33.33 ms
    budget. 1080p30 is met across the whole QP range but QP 14 is the edge. Rate
    control should hold a floor ar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
